ShivaniXR/LumiCatch/Assets/game over.png

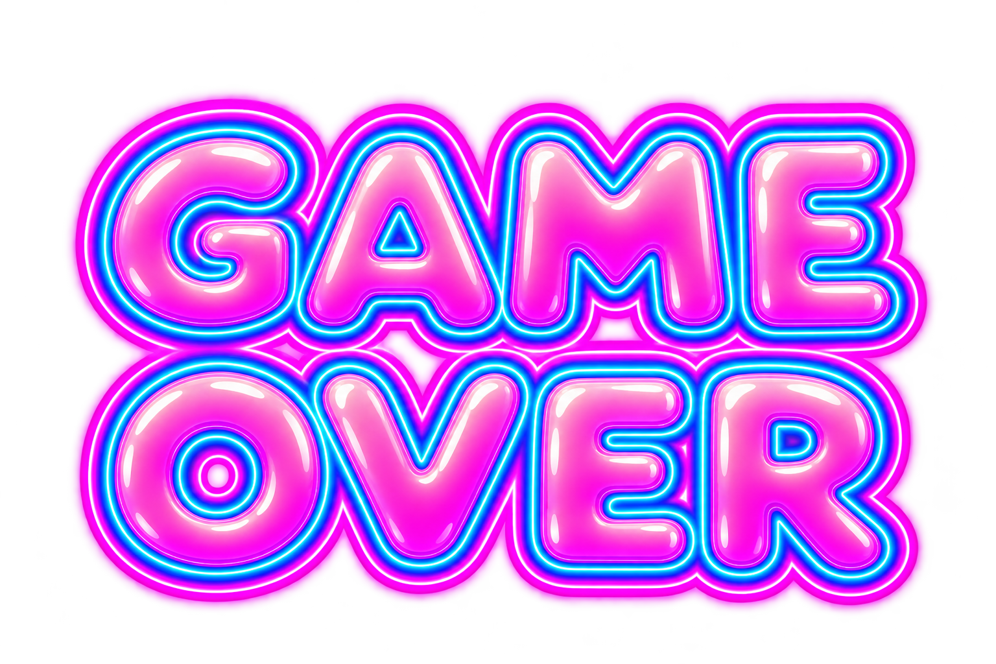
Assets/game over.png
