ShivaniXR/LumiCatch/Assets/1.png

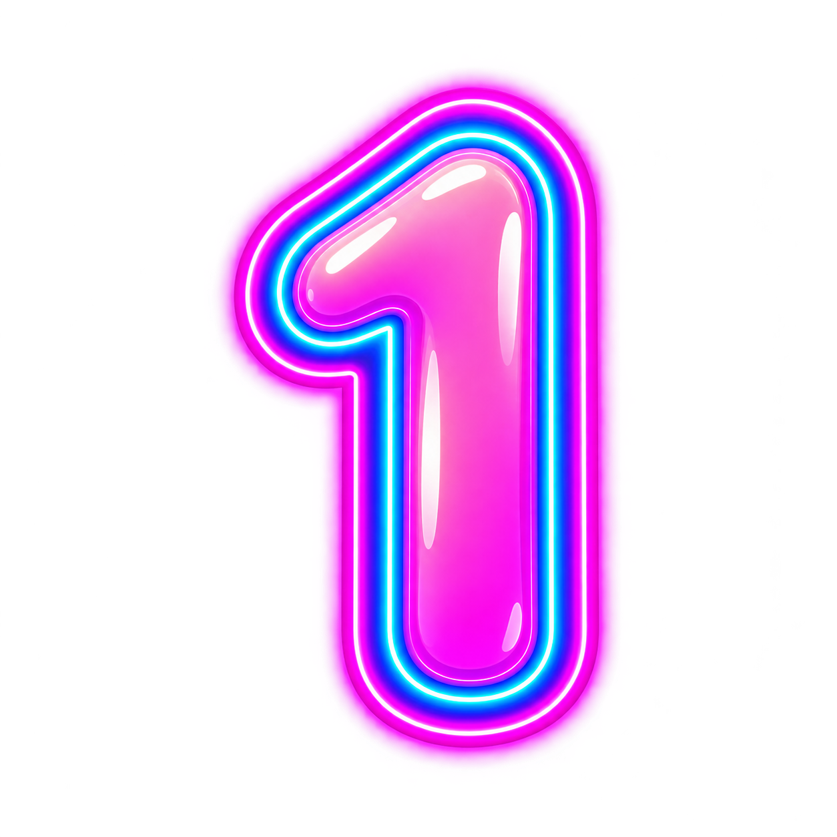
Assets/1.png
