ShivaniXR/LumiCatch/Assets/2.png

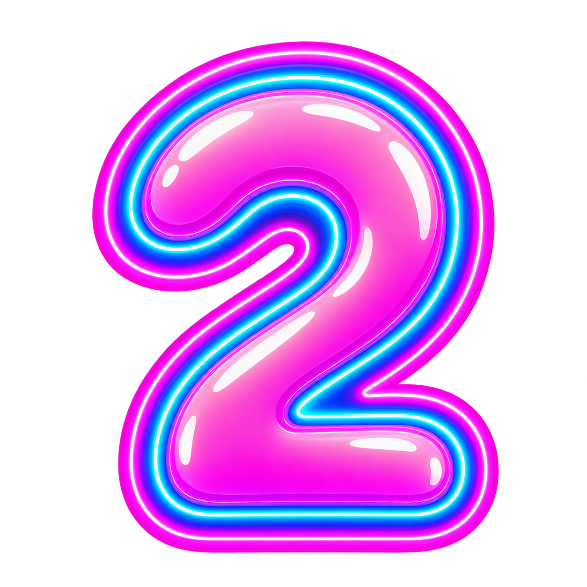
Assets/2.png
