ShivaniXR/LumiCatch/Assets/3.png

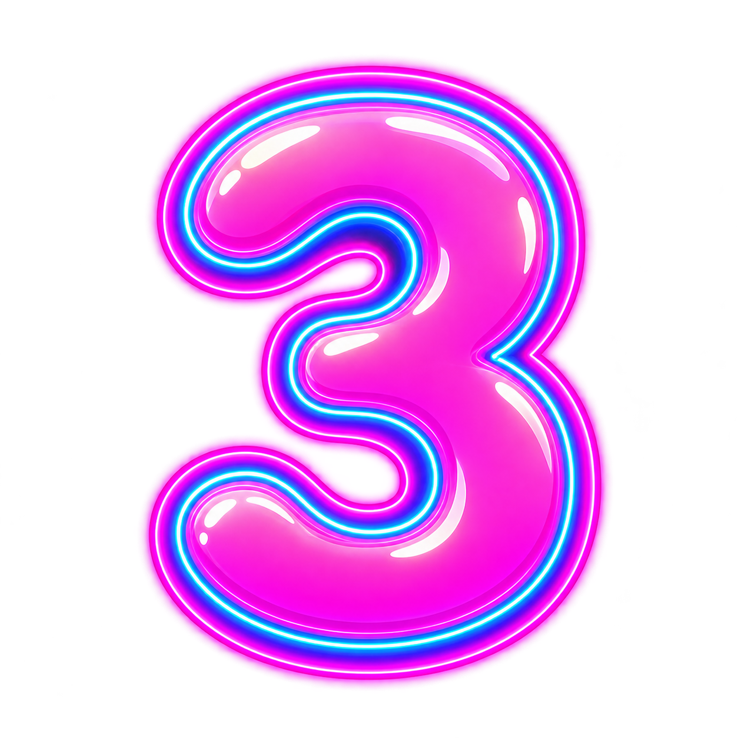
Assets/3.png
