ShivaniXR/LumiCatch/Assets/ChatGPT Image Sep 13, 2026 at 02_51_35 PM.png

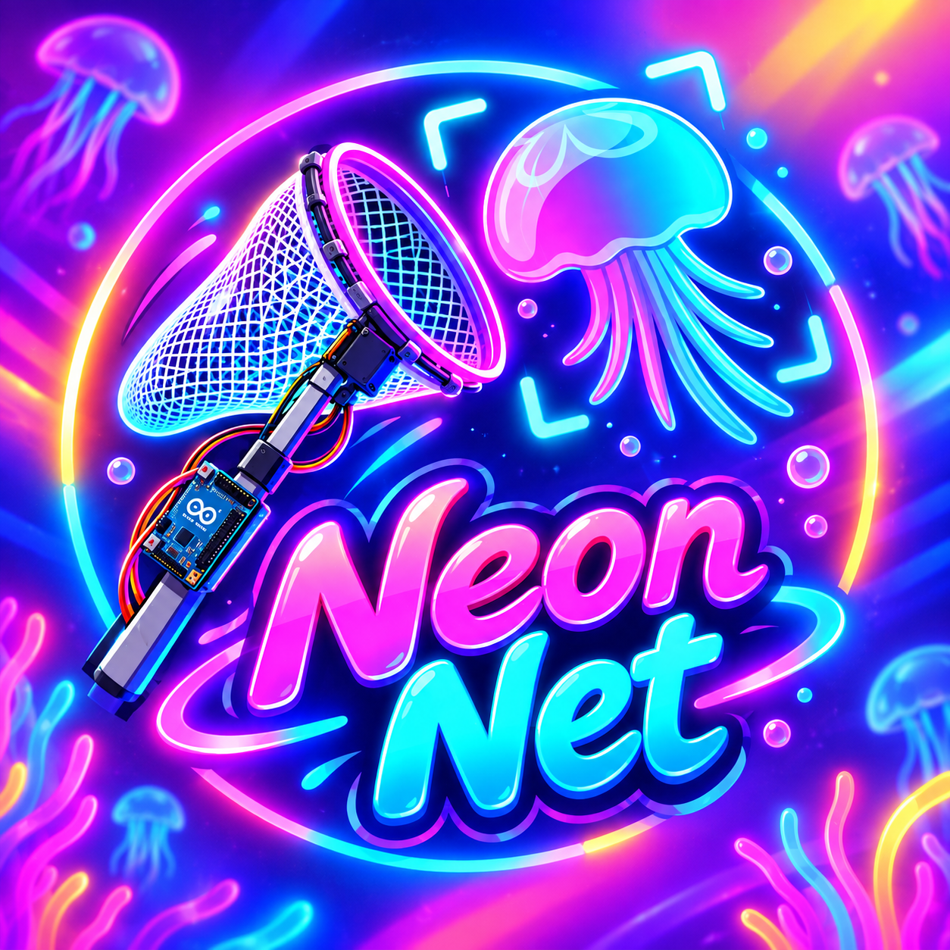
Assets/ChatGPT Image Sep 13, 2026 at 02_51_35 PM.png
