ShivaniXR/LumiCatch/Assets/GO.png

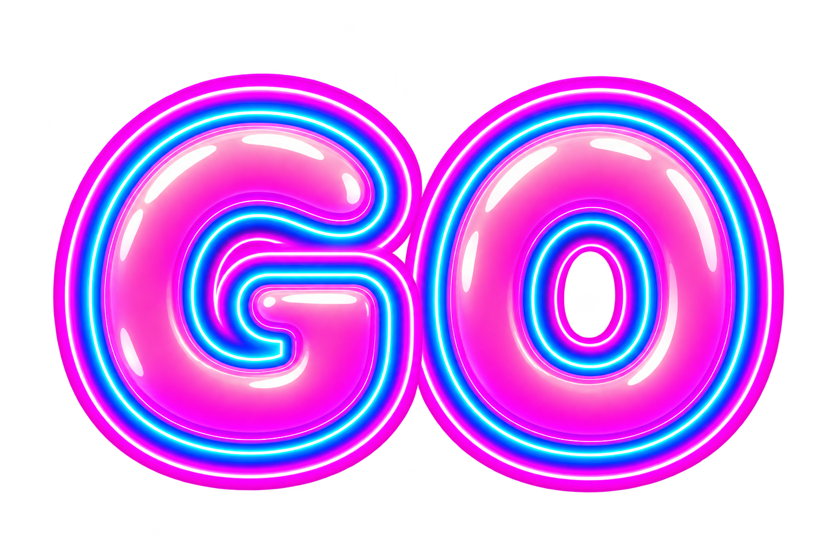
Assets/GO.png
