ShivaniXR/LumiCatch/Assets/multiplayer.png

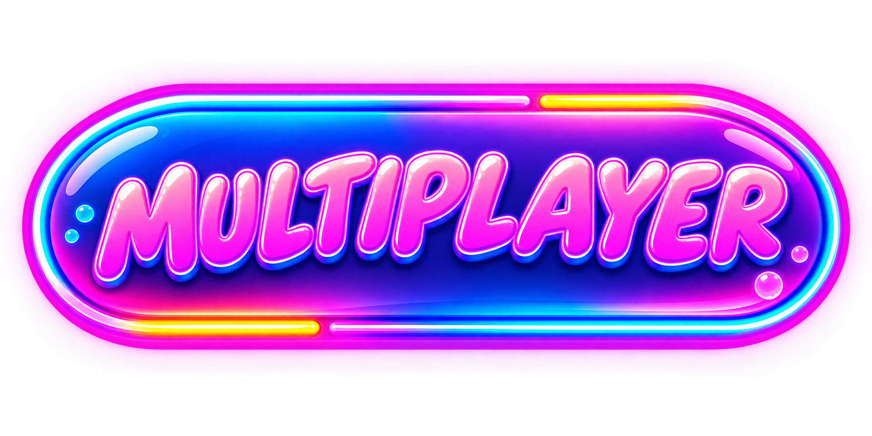
Assets/multiplayer.png
