ShivaniXR/LumiCatch/Assets/neon net.png

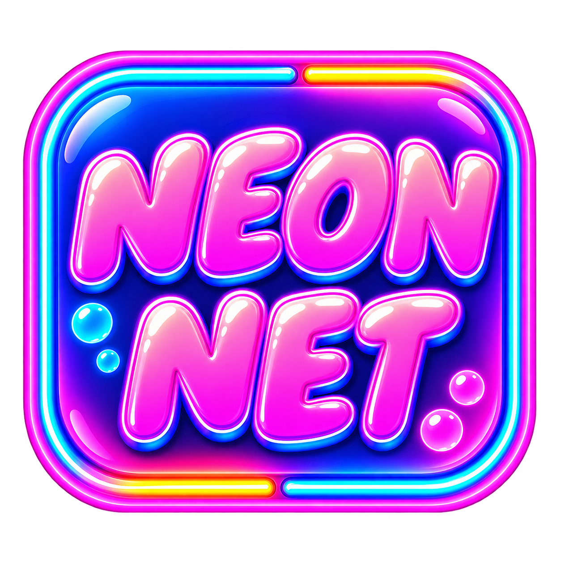
Assets/neon net.png
