ShivaniXR/LumiCatch/Assets/restart.png

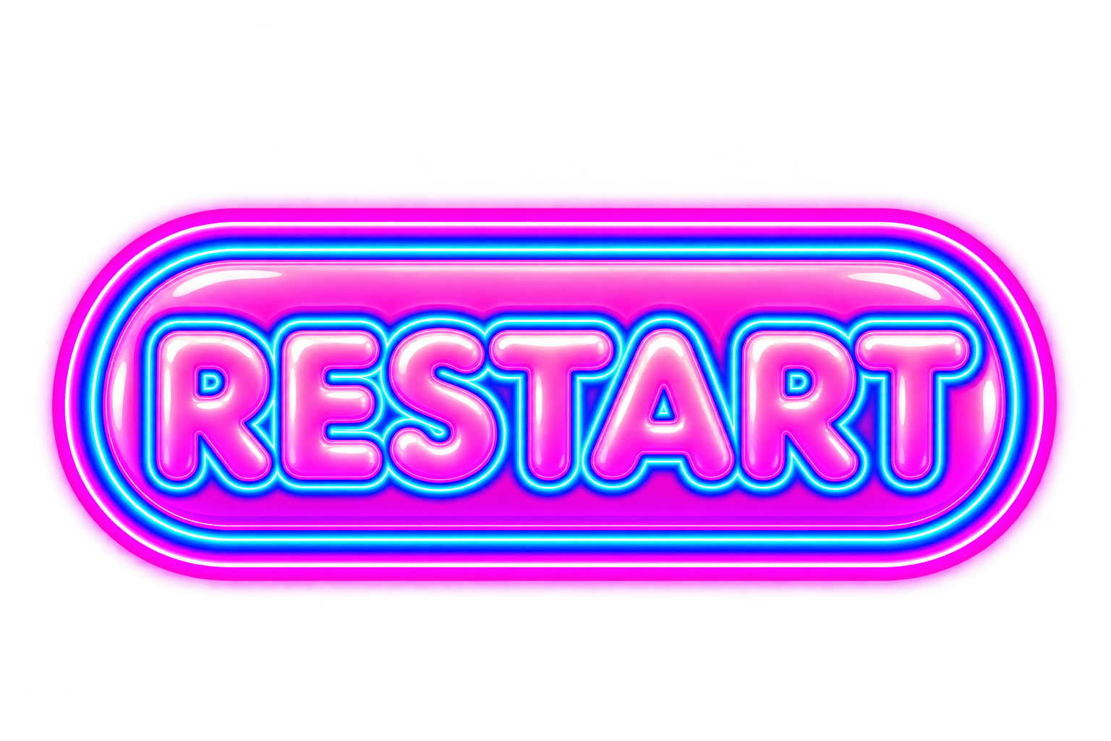
Assets/restart.png
