ShivaniXR/LumiCatch/Assets/solo.png

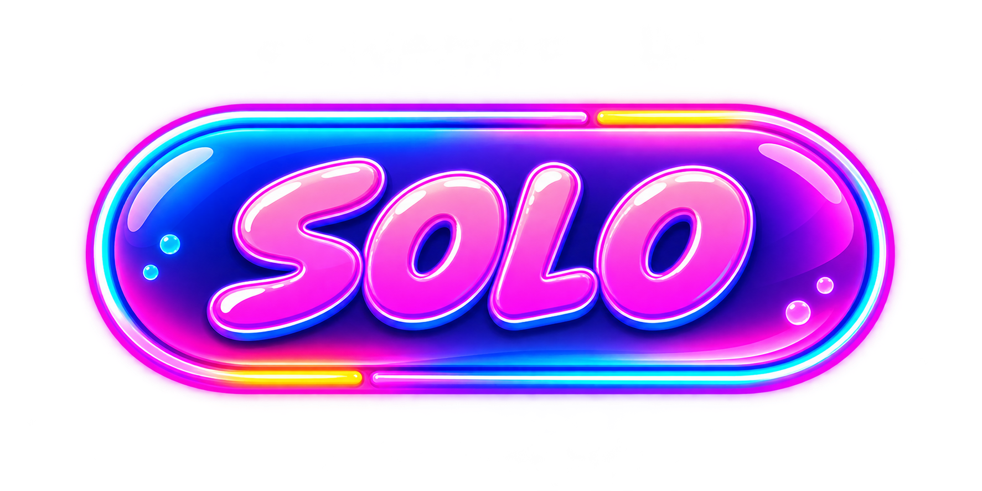
Assets/solo.png
