ShivaniXR/LumiCatch/breadboard-view.png

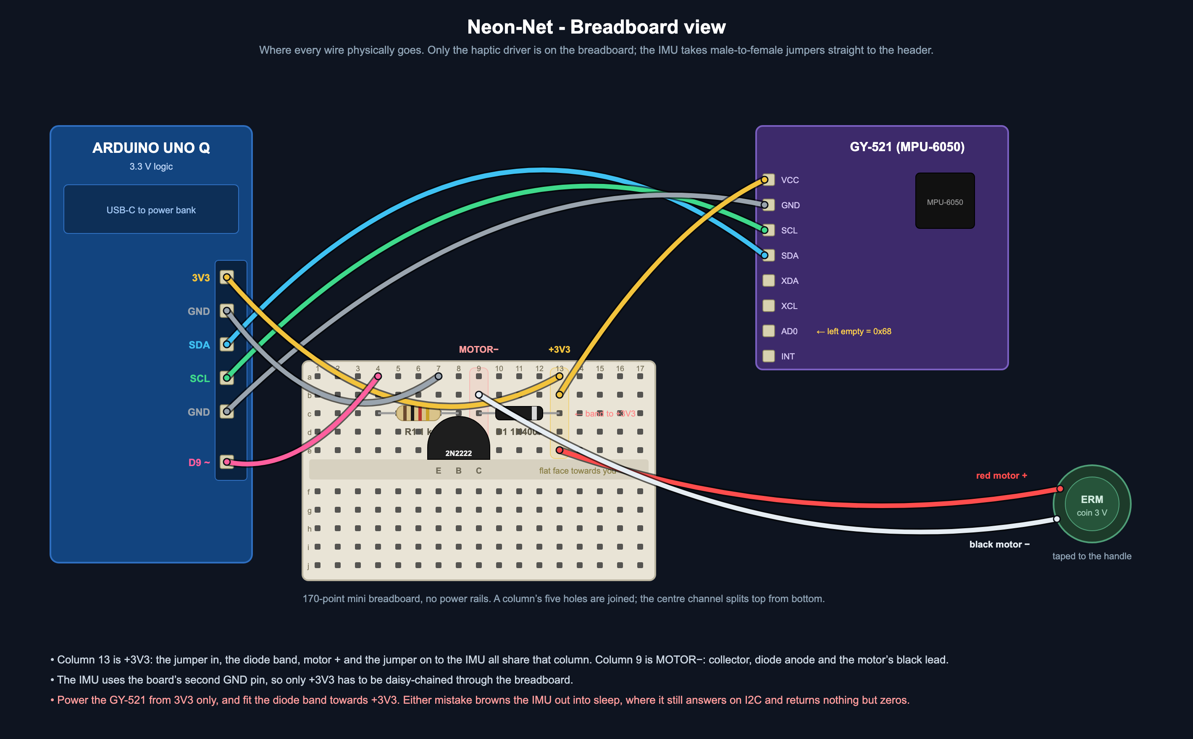
breadboard-view.png
