ShivaniXR/LumiCatch/diagram-dataflow.png

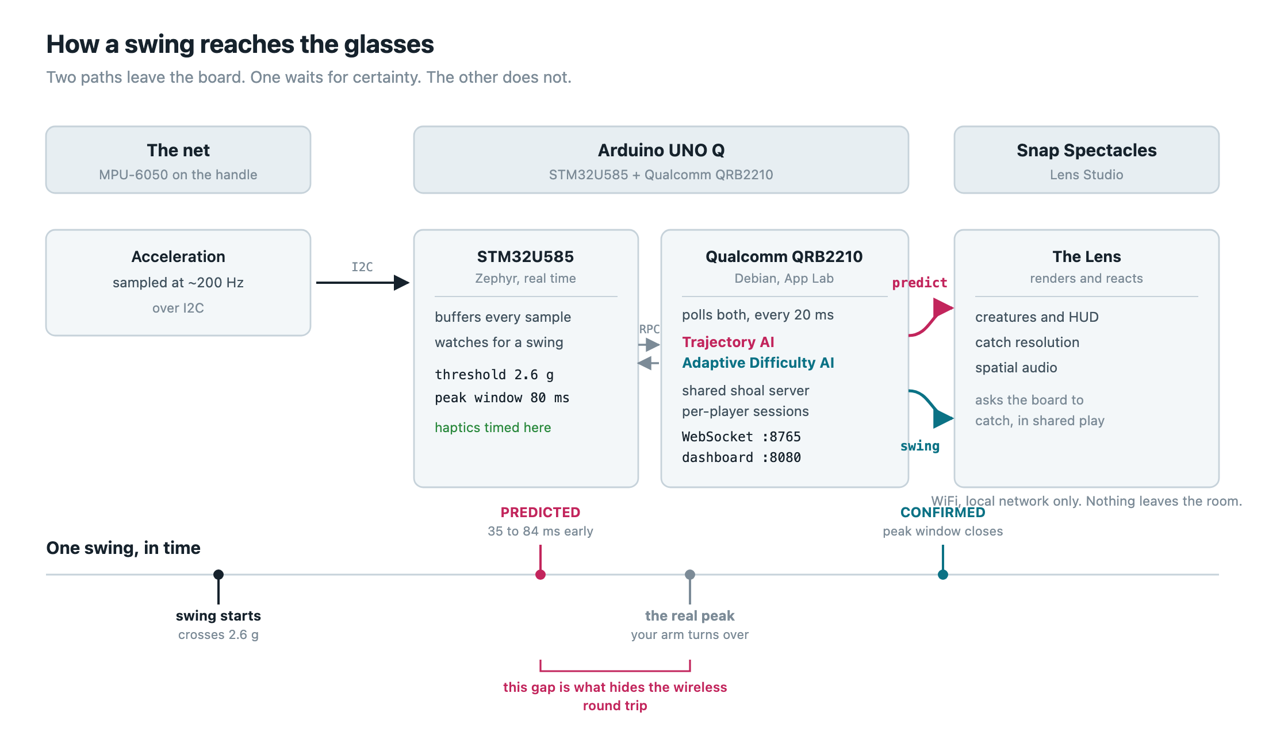
diagram-dataflow.png
