ShivaniXR/LumiCatch/diagram-prediction.png

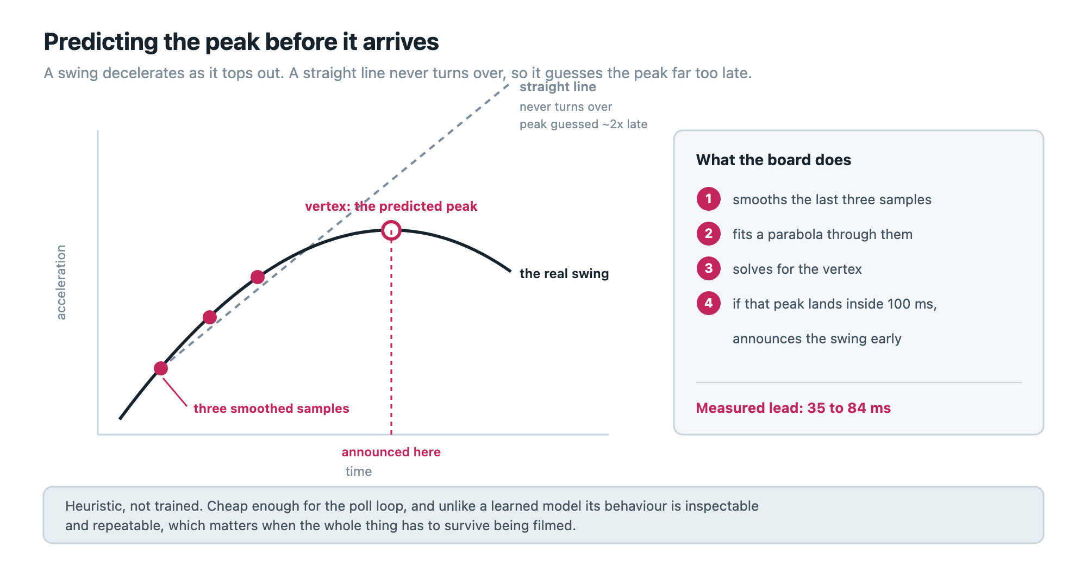
diagram-prediction.png
