ShivaniXR/LumiCatch/diagram-swingstate.png

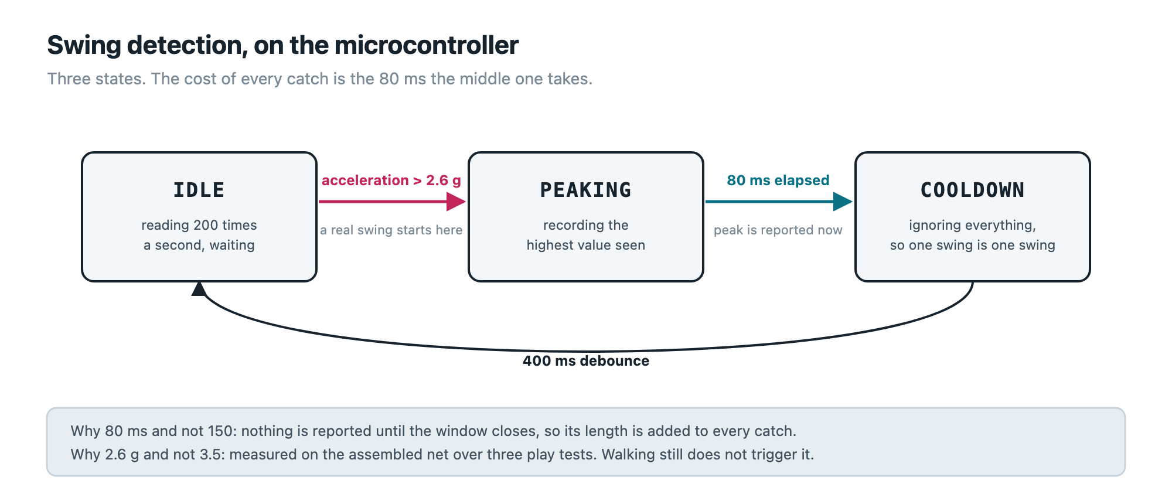
diagram-swingstate.png
