ShivaniXR/LumiCatch/schematic-haptic.png

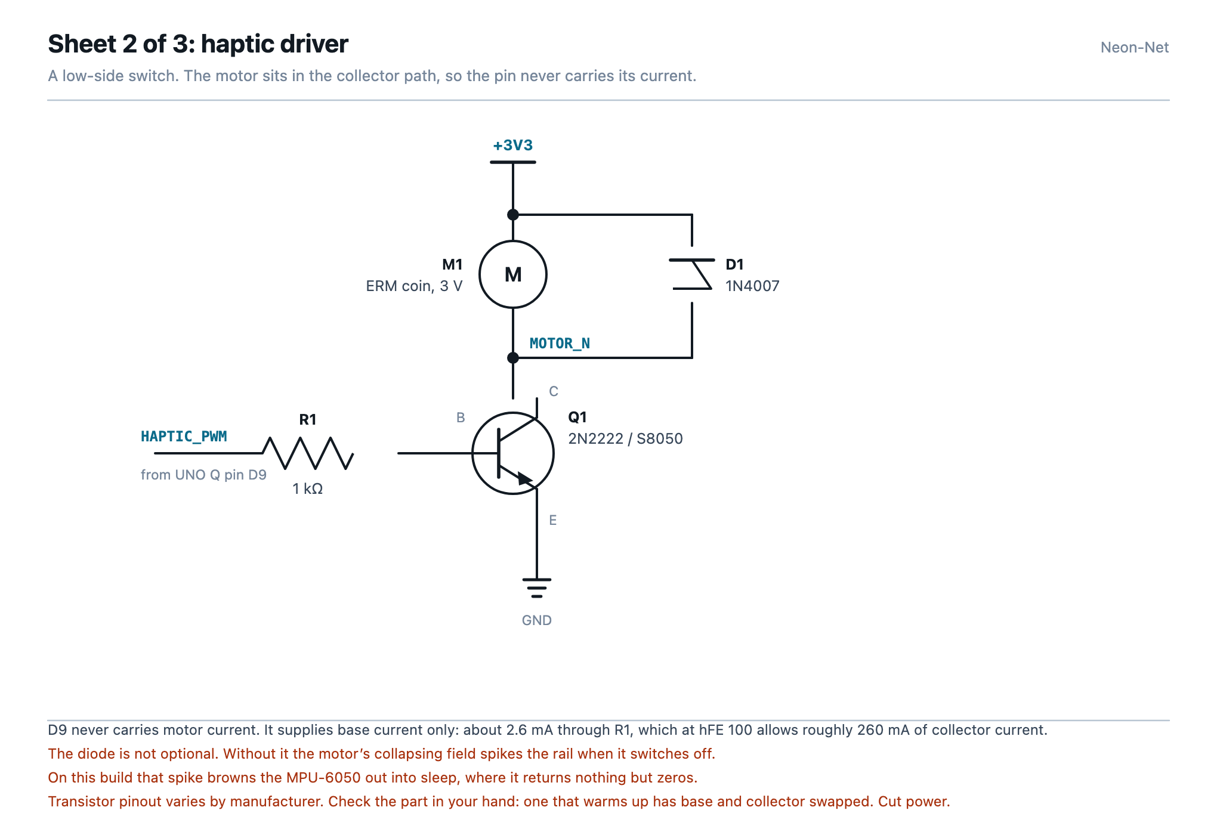
schematic-haptic.png
