ShivaniXR/LumiCatch/schematic-imu.png

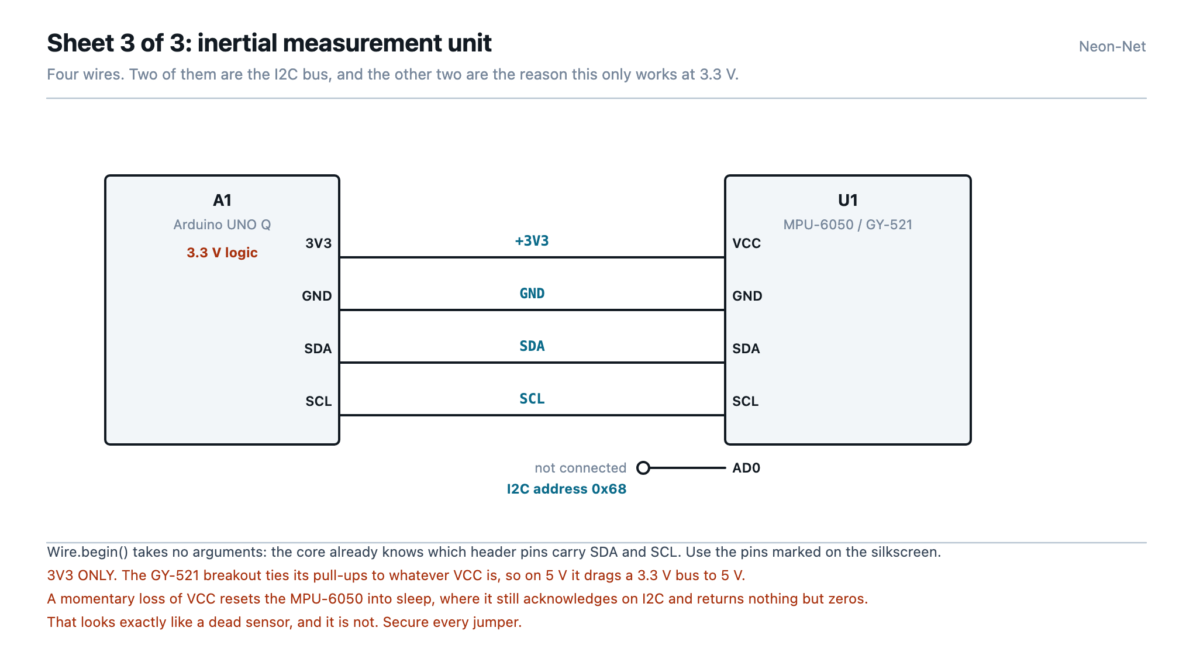
schematic-imu.png
