ShivaniXR/LumiCatch/schematic-pinmap.png

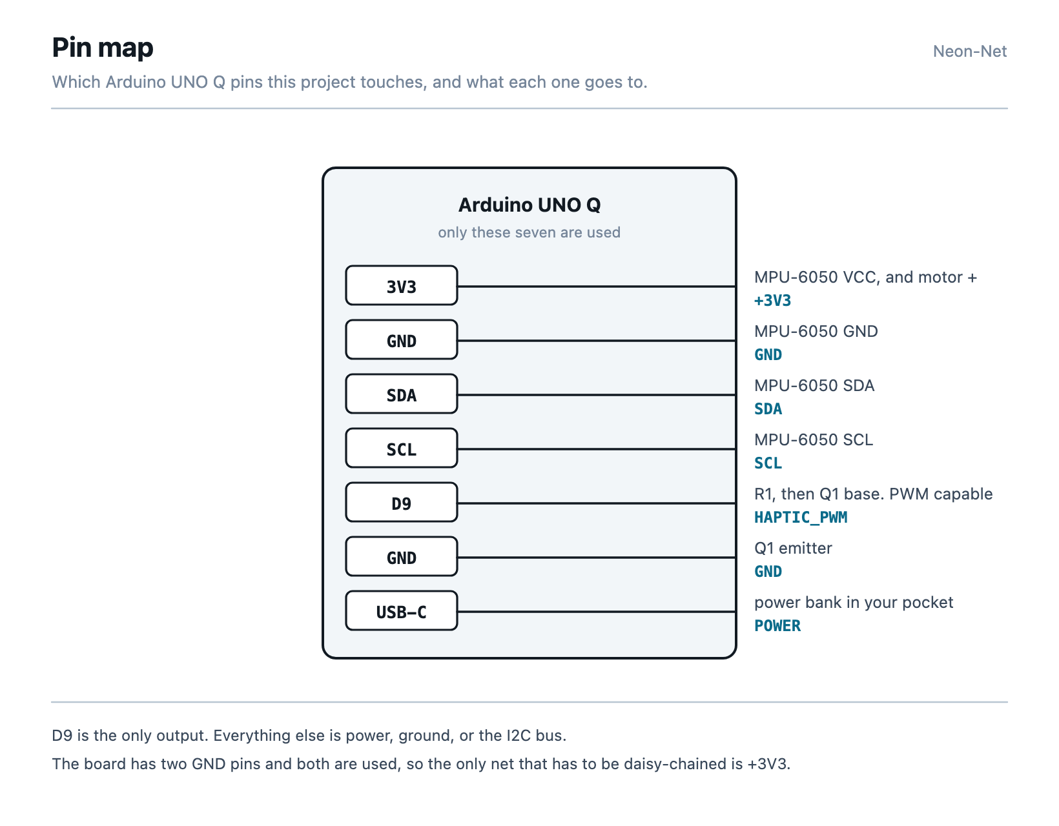
schematic-pinmap.png
