ShivaniXR/LumiCatch/schematic-system.png

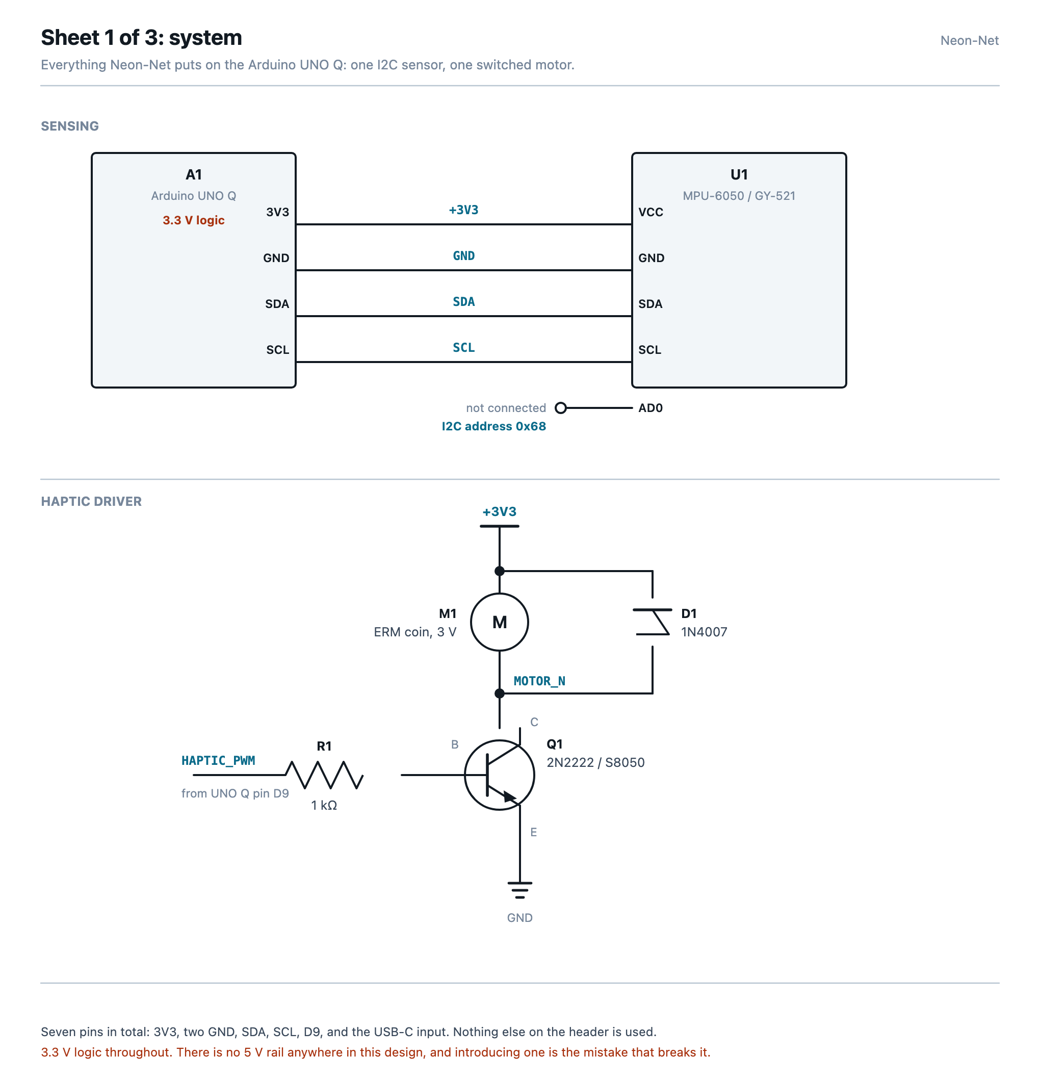
schematic-system.png
