ShivaniXR/LumiCatch/diagnostics/phase1-imu-test.ino

/*
 * Neon-Net Phase 1 - prove the MPU-6050 is alive
 * -----------------------------------------------
 * Wire ONLY the MPU-6050 for this. No motor, no transistor, no diode yet.
 * One thing at a time, so a failure has only one possible cause.
 *
 *   MPU-6050        UNO Q
 *   --------        -----
 *   VCC       ->    3V3           (never 5V, the module is 3.3 V)
 *   GND       ->    GND
 *   SDA       ->    pin marked SDA (same line as A4)
 *   SCL       ->    pin marked SCL (same line as A5)
 *
 * Wire.begin() takes no pin arguments on purpose: the core already knows the
 * board's default I2C pins, so there is nothing to look up or mistype.
 *
 * PRINTING ON THE UNO Q
 * Including Arduino_RouterBridge.h replaces the classic Serial with Monitor.
 * Monitor.begin() must be called or nothing reaches the App Lab console, and
 * a pause afterwards is needed before the first line survives. This is the
 * single most common reason a UNO Q sketch looks dead when it is running fine.
 *
 * This checks three things:
 *   1. That something actually answers at address 0x68.
 *   2. WHO_AM_I, which separates 'wiring wrong' from 'wrong chip'.
 *   3. Magnitude in g, plus the running peak. That is the exact signal the
 *      swing detector thresholds on and the trajectory model differentiates,
 *      so swinging the bare breadboard now tells you what to set the
 *      thresholds to before anything is taped to a net handle.
 */

#include <Wire.h>
#include "Arduino_RouterBridge.h"

const uint8_t MPU_ADDR_LOW  = 0x68;   // AD0 low or unconnected
const uint8_t MPU_ADDR_HIGH = 0x69;   // AD0 pulled high
uint8_t MPU_ADDR = MPU_ADDR_LOW;      // set to whichever actually answers
const uint8_t REG_WHO_AM_I = 0x75;
const uint8_t REG_PWR_MGMT = 0x6B;
const uint8_t REG_ACC_CFG  = 0x1C;
const uint8_t REG_ACC_XOUT = 0x3B;
const float   LSB_PER_G    = 4096.0f;   // +/-8 g range

float peakSeen = 0.0f;
unsigned long lastPrint = 0;
int zeroRun = 0;          // consecutive dead reads
int recoveries = 0;       // how many times we have revived the sensor

void mpuWrite(uint8_t reg, uint8_t val) {
  Wire.beginTransmission(MPU_ADDR);
  Wire.write(reg);
  Wire.write(val);
  Wire.endTransmission();
}

uint8_t mpuRead(uint8_t reg) {
  Wire.beginTransmission(MPU_ADDR);
  Wire.write(reg);
  Wire.endTransmission(false);
  Wire.requestFrom((int)MPU_ADDR, 1);
  if (Wire.available()) return Wire.read();
  return 0xFF;
}

bool mpuReadAccel(float &gx, float &gy, float &gz) {
  Wire.beginTransmission(MPU_ADDR);
  Wire.write(REG_ACC_XOUT);
  if (Wire.endTransmission(false) != 0) return false;
  if (Wire.requestFrom((int)MPU_ADDR, 6) != 6) return false;
  int16_t rx = (Wire.read() << 8) | Wire.read();
  int16_t ry = (Wire.read() << 8) | Wire.read();
  int16_t rz = (Wire.read() << 8) | Wire.read();
  gx = rx / LSB_PER_G;
  gy = ry / LSB_PER_G;
  gz = rz / LSB_PER_G;
  return true;
}

/*
 * Wake the sensor and set its range. Split out from setup() because it has to
 * be callable again at runtime: if the module browns out for even a moment,
 * say a jumper twitching while you swing, it resets straight back into sleep
 * mode. Asleep it still acknowledges on I2C perfectly happily and simply
 * returns zeros for every data register, so the failure is completely silent.
 */
void mpuInit() {
  mpuWrite(REG_PWR_MGMT, 0x00);   // out of sleep
  delay(10);
  mpuWrite(REG_ACC_CFG, 0x10);    // +/-8 g, matches sketch.ino
  delay(10);
}

void setup() {
  Monitor.begin();
  delay(3000);          // without this the opening lines are lost

  Wire.begin();
  delay(200);

  Monitor.println("");
  Monitor.println("=== Neon-Net Phase 1: IMU check ===");

  // --- Test 1: is anything on the bus, at either address? ---
  bool found = false;
  const uint8_t candidates[2] = { MPU_ADDR_LOW, MPU_ADDR_HIGH };
  for (int i = 0; i < 2 && !found; i++) {
    Wire.beginTransmission(candidates[i]);
    if (Wire.endTransmission() == 0) {
      MPU_ADDR = candidates[i];
      found = true;
    }
  }
  if (!found) {
    Monitor.println("FAIL: nothing answering at 0x68 or 0x69.");
    Monitor.println("      Check SDA and SCL are not swapped.");
    Monitor.println("      Check VCC is on 3V3 and GND is connected.");
    Monitor.println("      If the module has an AD0 pin, leave it unconnected.");
    Monitor.println("      Check VCC and GND first: no power means no answer.");
  } else {
    Monitor.print("PASS: a device answered at 0x");
    Monitor.println(MPU_ADDR, HEX);
  }

  // --- Test 2: is it the chip we think it is? ---
  uint8_t who = mpuRead(REG_WHO_AM_I);
  Monitor.print("WHO_AM_I = 0x");
  Monitor.println(who, HEX);
  if (who == 0x68) {
    Monitor.println("PASS: genuine MPU-6050");
  } else if (who == 0x70 || who == 0x71 || who == 0x73) {
    Monitor.println("NOTE: MPU-6500/9250 clone. Fine, same registers.");
  } else {
    Monitor.println("WARN: unexpected WHO_AM_I, recheck wiring");
  }

  // --- Wake it and set the range ---
  mpuInit();
  delay(50);

  Monitor.println("");
  Monitor.println("Hold it still: magnitude should sit near 1.00 g.");
  Monitor.println("Then swing it like a net and watch the peak.");
  Monitor.println("");
}

void loop() {
  float gx, gy, gz;
  if (!mpuReadAccel(gx, gy, gz)) {
    Monitor.println("read failed");
    delay(500);
    return;
  }

  float mag = sqrtf(gx * gx + gy * gy + gz * gz);

  // Gravity is always there, so a magnitude of essentially zero means the
  // sensor has dropped back into sleep, not that the net is weightless.
  // Twenty dead samples is 100 ms, short enough that a swing survives it.
  if (mag < 0.05f) {
    zeroRun++;
    if (zeroRun >= 20) {
      zeroRun = 0;
      recoveries++;
      mpuInit();
      Monitor.print("!! sensor had reset to sleep, woken again (recovery #");
      Monitor.print(recoveries);
      Monitor.println("). Check VCC and GND are firmly seated.");
    }
  } else {
    zeroRun = 0;
  }

  if (mag > peakSeen) peakSeen = mag;

  // Sample fast so the peak is real, print slowly so it stays readable.
  if (millis() - lastPrint >= 200) {
    lastPrint = millis();
    Monitor.print("x ");   Monitor.print(gx, 2);
    Monitor.print("  y "); Monitor.print(gy, 2);
    Monitor.print("  z "); Monitor.print(gz, 2);
    Monitor.print("   |mag| "); Monitor.print(mag, 2);
    Monitor.print(" g   peak "); Monitor.print(peakSeen, 2);
    Monitor.println(" g");
  }

  delay(5);   // ~200 Hz, the same rate the real firmware samples at
}
