ShivaniXR/LumiCatch/(commit log)

2026-09-11 Checkpoint before cleanup: audio, start screen, mounted-net calibration
2026-09-11 Remove unused websockets build, retarget generator at the no-deps build
    - main.py and main-standalone.py used the websockets package, which App Lab
    would not install. The raw-socket build is what actually runs on the board.
    - phase1-imu-diagnose.ino tested a repeated-start theory that turned out to be
    wrong; i2c-scan.ino supersedes it.
    - build-standalone.py now generates main-nodeps-standalone.py.
    [build-standalone.py]
2026-09-11 Turn off the swing diagnostic buzz for play and filming
    [sketch.ino]
